Scouttman/STSPIN32G4/STSPIN32G4_V2.kicad_pcb

## KiCad design STSPIN32G4_V2.kicad_pcb (2023-10-10)

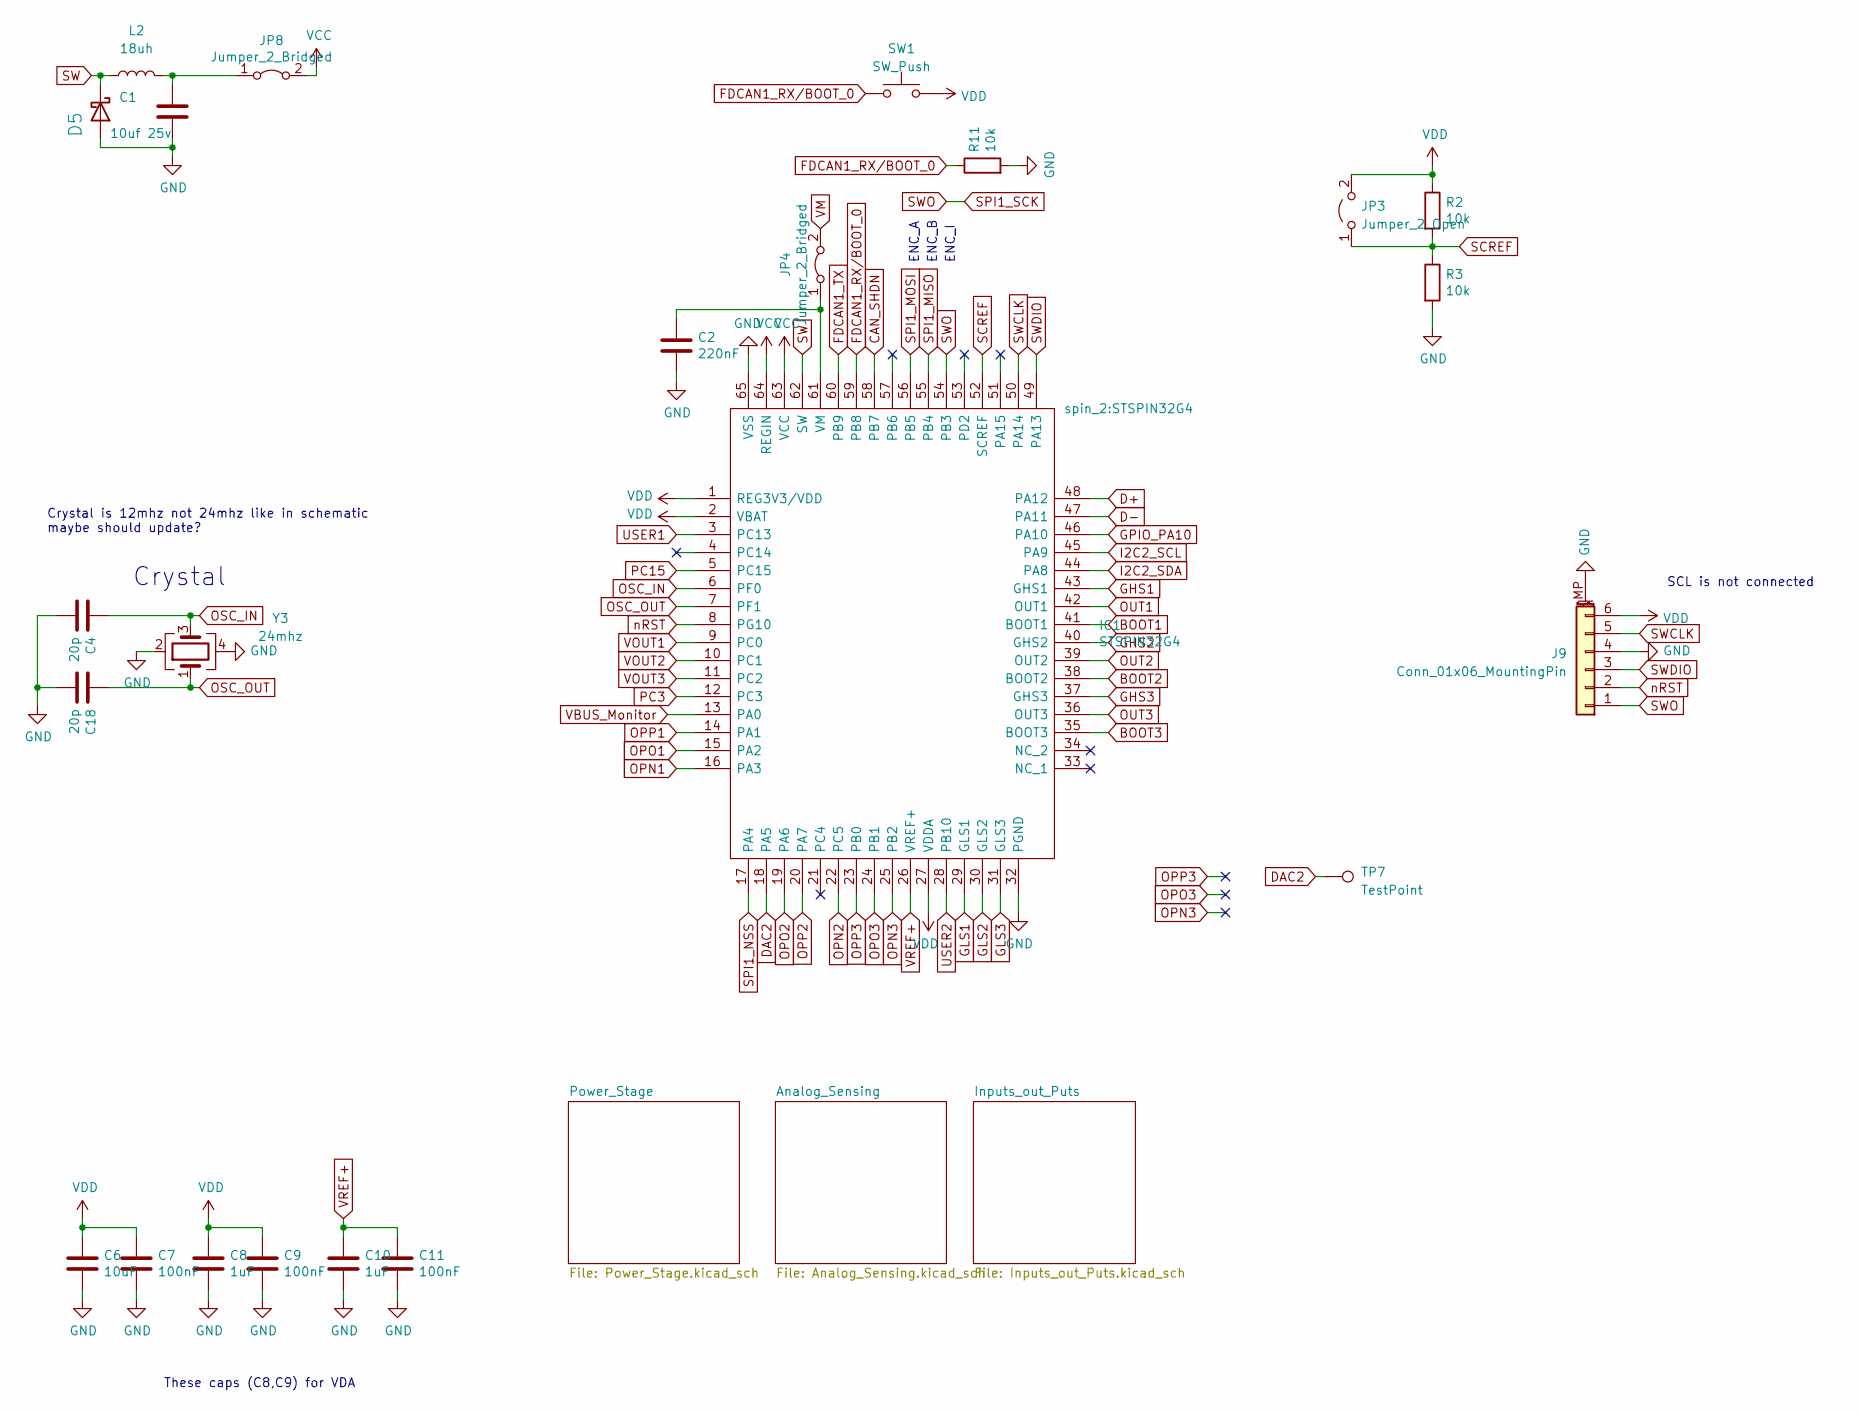
[picture p5: schematic STSPIN32G4_V2.kicad_sch]

Parts:
C1: 10uf 25v; C_0805_2012Metric
C2: 220nF; C_0805_2012Metric
C4, C18: 20p; C_0402_1005Metric
C6: 10uF; C_0805_2012Metric; LCSC Part C15850
C7, C9, C11: 100nF; C_0402_1005Metric
C8, C10: 1uF; C_0402_1005Metric
D5: SS210; D_SOD-323; LCSC C191023
IC1: STSPIN32G4; Manufacturer_Part_Number STSPIN32G4; Mouser Part Number 511-STSPIN32G4
J9: Conn_01x06_MountingPin; JST_SH_BM06B-SRSS-TB_1x06-1MP_P1.00mm_Vertical
JP3: Jumper_2_Open; SolderJumper-2_P1.3mm_Open_TrianglePad1.0x1.5mm
JP4, JP8: Jumper_2_Bridged; SolderJumper-2_P1.3mm_Bridged_RoundedPad1.0x1.5mm
L2: 18uh; L_1812_4532Metric; LCSC C394124
R2, R3, R11: 10k; R_0402_1005Metric
SW1: SW_Push; SolderJumper-2_P1.3mm_Open_RoundedPad1.0x1.5mm
TP7: TestPoint; TestPoint_Pad_D1.5mm
Y3: 24mhz; Crystal_SMD_3225-4Pin_3.2x2.5mm; LCSC C9002

Connections:
BOOT1: IC1.41 (BOOT1); also elsewhere on the board
BOOT2: IC1.38 (BOOT2); also elsewhere on the board
BOOT3: IC1.35 (BOOT3); also elsewhere on the board
CAN_SHDN: IC1.58 (PB7); also elsewhere on the board
D+: IC1.48 (PA12); also elsewhere on the board
D-: IC1.47 (PA11); also elsewhere on the board
DAC2: IC1.18 (PA5), TP7.1; also elsewhere on the board
FDCAN1_RX/BOOT_0: IC1.59 (PB8), R11.1, SW1.1; also elsewhere on the board
FDCAN1_TX: IC1.60 (PB9); also elsewhere on the board
GHS1: IC1.43 (GHS1); also elsewhere on the board
GHS2: IC1.40 (GHS2); also elsewhere on the board
GHS3: IC1.37 (GHS3); also elsewhere on the board
GLS1: IC1.29 (GLS1); also elsewhere on the board
GLS2: IC1.30 (GLS2); also elsewhere on the board
GLS3: IC1.31 (GLS3); also elsewhere on the board
GND: C1.2, C2.2, C4.2, C6.2, C7.2, C8.2, C9.2, C10.2, C11.2, C18.2, D5.2 (A), IC1.32 (PGND), IC1.65 (VSS), J9.4, J9.MP (MountPin), R3.2, R11.2, Y3.2, Y3.4; also elsewhere on the board
GPIO_PA10: IC1.46 (PA10); also elsewhere on the board
I2C2_SCL: IC1.45 (PA9); also elsewhere on the board
I2C2_SDA: IC1.44 (PA8); also elsewhere on the board
unnamed 30: IC1.51 (PA15); also elsewhere on the board
unnamed 31: IC1.53 (PD2); also elsewhere on the board
unnamed: C2.1, IC1.61 (VM), JP4.1 (A)
unnamed: C1.1, JP8.1 (A), L2.2
OPN1: IC1.16 (PA3); also elsewhere on the board
OPN2: IC1.22 (PC5); also elsewhere on the board
OPN3: IC1.25 (PB2)
OPO1: IC1.15 (PA2); also elsewhere on the board
OPO2: IC1.19 (PA6); also elsewhere on the board
OPO3: IC1.24 (PB1)
OPP1: IC1.14 (PA1); also elsewhere on the board
OPP2: IC1.20 (PA7); also elsewhere on the board
OPP3: IC1.23 (PB0)
OSC_IN: C4.1, IC1.6 (PF0), Y3.3
OSC_OUT: C18.1, IC1.7 (PF1), Y3.1
OUT1: IC1.42 (OUT1); also elsewhere on the board
OUT2: IC1.39 (OUT2); also elsewhere on the board
OUT3: IC1.36 (OUT3); also elsewhere on the board
PC3: IC1.12 (PC3)
PC15: IC1.5 (PC15)
SCREF: IC1.52 (SCREF), JP3.1 (A), R2.2, R3.1
SPI1_MISO: IC1.55 (PB4); also elsewhere on the board
SPI1_MOSI: IC1.56 (PB5); also elsewhere on the board
SPI1_NSS: IC1.17 (PA4); also elsewhere on the board
SPI1_SCK: IC1.54 (PB3), J9.1; also elsewhere on the board
SW: D5.1 (K), IC1.62 (SW), L2.1
SWCLK: IC1.50 (PA14), J9.5
SWDIO: IC1.49 (PA13), J9.3
USER1: IC1.3 (PC13); also elsewhere on the board
USER2: IC1.28 (PB10); also elsewhere on the board
VBUS_Monitor: IC1.13 (PA0); also elsewhere on the board
VCC: IC1.63 (VCC), IC1.64 (REGIN), JP8.2 (B); also elsewhere on the board
VDD: C6.1, C7.1, C8.1, C9.1, IC1.1 (REG3V3/VDD), IC1.2 (VBAT), IC1.27 (VDDA), J9.6, JP3.2 (B), R2.1, SW1.2; also elsewhere on the board
VM: JP4.2 (B); also elsewhere on the board
VOUT1: IC1.9 (PC0)
VOUT2: IC1.10 (PC1)
VOUT3: IC1.11 (PC2)
VREF+: C10.1, C11.1, IC1.26 (VREF+); also elsewhere on the board
nRST: IC1.8 (PG10), J9.2

Notes on the sheet:
ENC_I
These caps (C8,C9) for VDA
ENC_B
Crystal
ENC_A
Crystal is 12mhz not 24mhz like in schematic maybe should update?
SCL is not connected

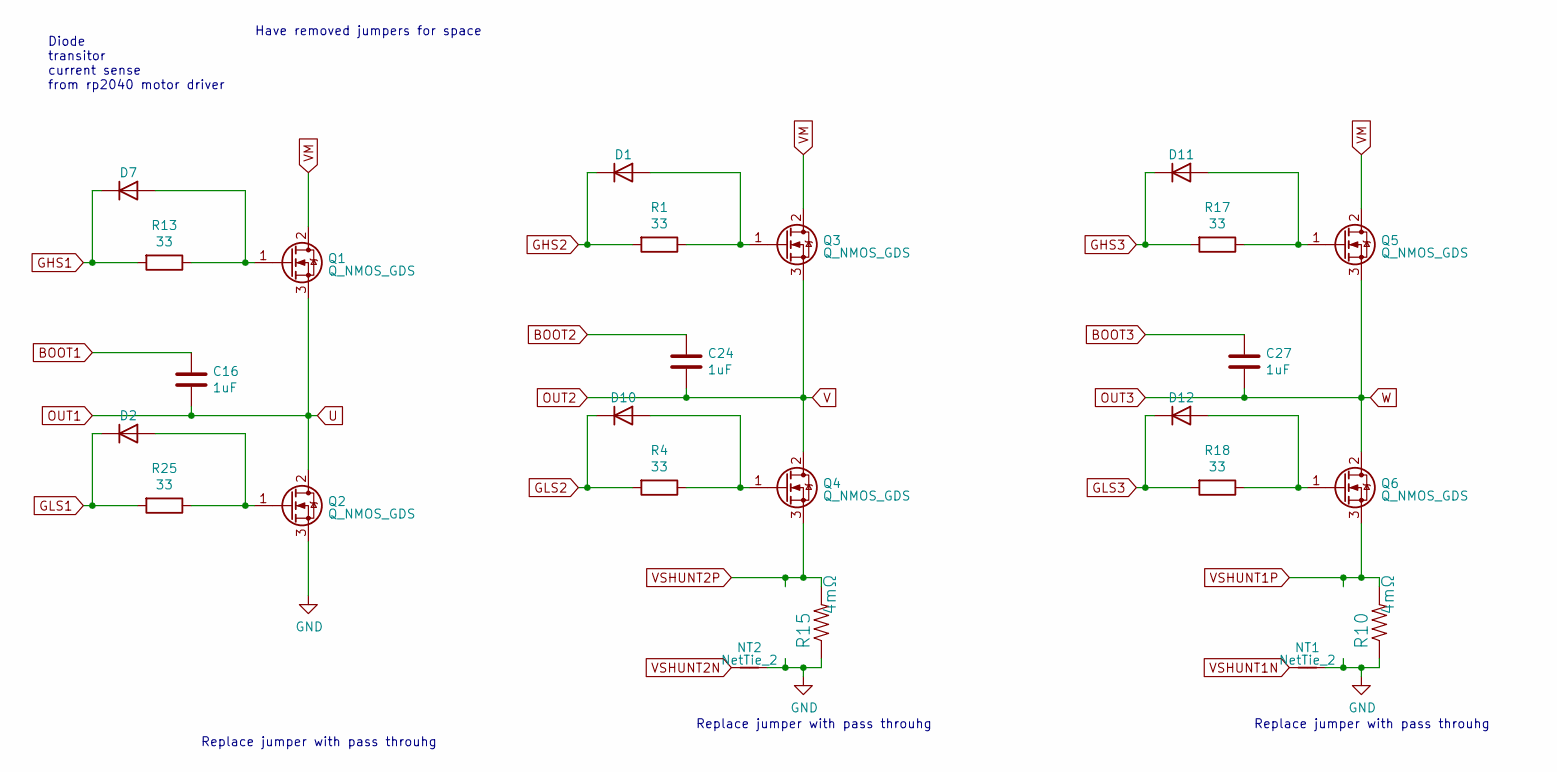
[picture p6: schematic Power_Stage.kicad_sch]

Parts:
C16, C24, C27: 1uF; C_0805_2012Metric; LCSC Part C28323
D1, D2, D7, D10, D11, D12: 1N4148WS; D_SOD-323; LCSC C2128
NT1, NT2: NetTie_2; NetTie-2_SMD_Pad0.5mm
Q1, Q2, Q3, Q4, Q5, Q6: Q_NMOS_GDS; DFN-8-1EP_6x5mm_P1.27mm_EP4x4mm; LCSC Part C180959
R1, R4, R13, R17, R18, R25: 33; R_0402_1005Metric
R10, R15: 4mΩ; R_2512_6332Metric; LCSC C375693

Connections:
BOOT1: C16.2; also elsewhere on the board
BOOT2: C24.2; also elsewhere on the board
BOOT3: C27.2; also elsewhere on the board
GHS1: D7.1 (K), R13.2; also elsewhere on the board
GHS2: D1.1 (K), R1.2; also elsewhere on the board
GHS3: D11.1 (K), R17.2; also elsewhere on the board
GLS1: D2.1 (K), R25.2; also elsewhere on the board
GLS2: D10.1 (K), R4.2; also elsewhere on the board
GLS3: D12.1 (K), R18.2; also elsewhere on the board
GND: NT1.2, NT2.2, Q2.3 (S), R10.1, R15.1; also elsewhere on the board
unnamed: D1.2 (A), Q3.1 (G), R1.1
unnamed: D2.2 (A), Q2.1 (G), R25.1
unnamed: D7.2 (A), Q1.1 (G), R13.1
unnamed: D10.2 (A), Q4.1 (G), R4.1
unnamed: D11.2 (A), Q5.1 (G), R17.1
unnamed: D12.2 (A), Q6.1 (G), R18.1
OUT1: C16.1, Q1.3 (S), Q2.2 (D); also elsewhere on the board
OUT2: C24.1, Q3.3 (S), Q4.2 (D); also elsewhere on the board
OUT3: C27.1, Q5.3 (S), Q6.2 (D); also elsewhere on the board
VM: Q1.2 (D), Q3.2 (D), Q5.2 (D); also elsewhere on the board
VSHUNT1N: NT1.1; also elsewhere on the board
VSHUNT1P: Q6.3 (S), R10.2; also elsewhere on the board
VSHUNT2N: NT2.1; also elsewhere on the board
VSHUNT2P: Q4.3 (S), R15.2; also elsewhere on the board

Notes on the sheet:
Replace jumper with pass throuhg
Have removed jumpers for space
Diode transitor current sense from rp2040 motor driver

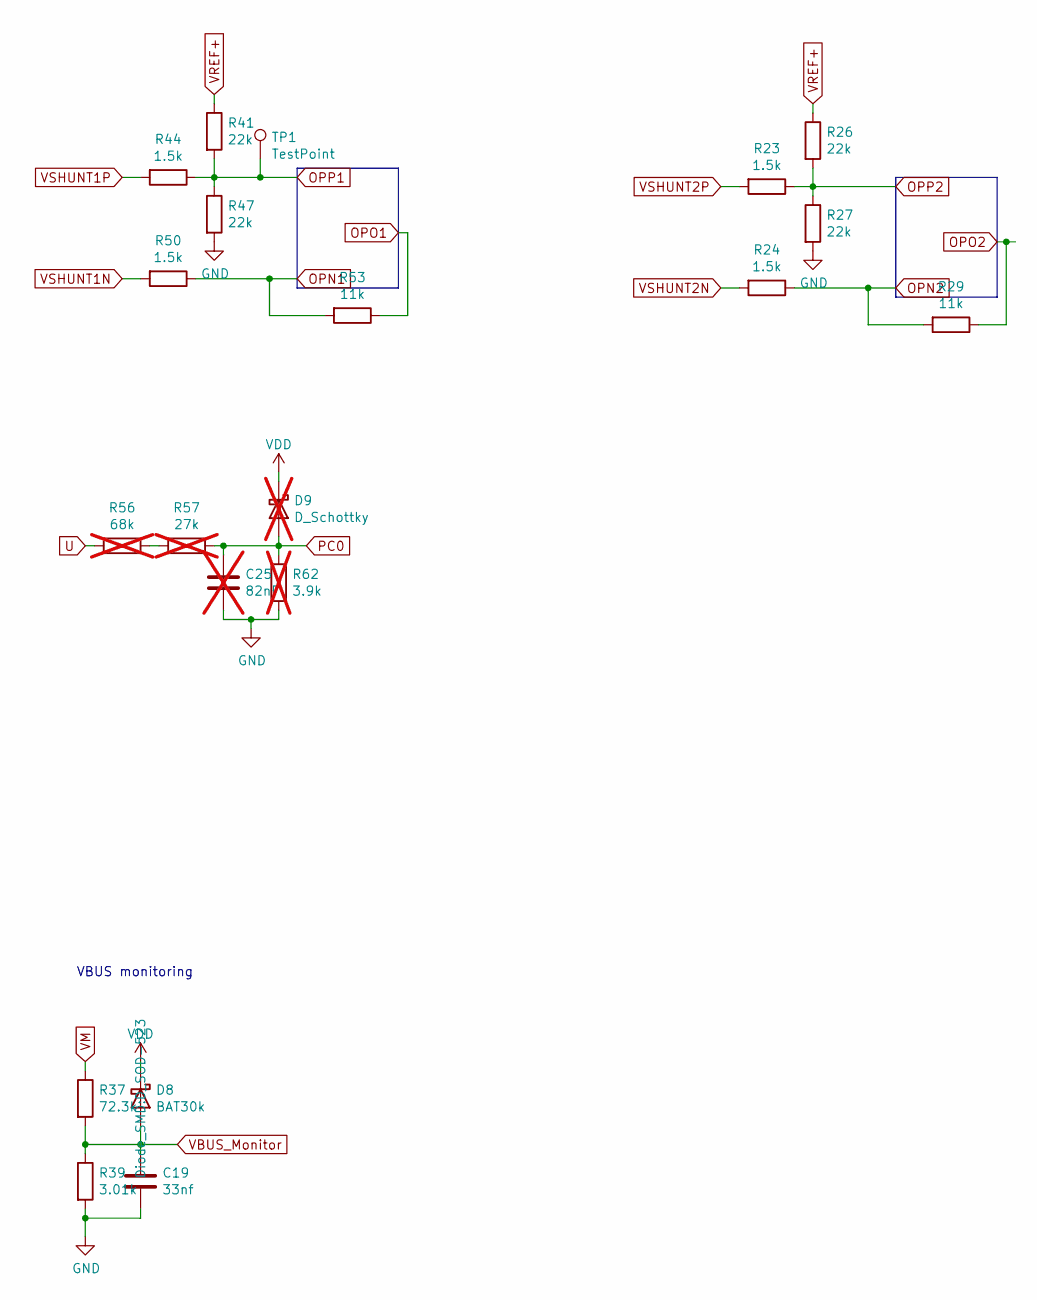
[picture p7: schematic Analog_Sensing.kicad_sch]

Parts:
C19: 33nf; C_0402_1005Metric
C25: 82nF; C_0402_1005Metric; not fitted
D8: BAT30k; D_SOD-523
D9: D_Schottky; D_SOD-523; not fitted
R23, R24, R44, R50: 1.5k; R_0402_1005Metric
R26, R27, R41, R47: 22k; R_0402_1005Metric
R29, R53: 11k; R_0402_1005Metric; LCSC C409665
R37: 72.3k; R_0402_1005Metric
R39: 3.01k; R_0402_1005Metric
R56: 68k; R_0402_1005Metric; not fitted
R57: 27k; R_0402_1005Metric; not fitted
R62: 3.9k; R_0402_1005Metric; not fitted
TP1: TestPoint; TestPoint_Pad_D2.0mm

Connections:
GND: C19.2, C25.2, R27.2, R39.2, R47.2, R62.2; also elsewhere on the board
unnamed: R56.1, R57.2
OPN1: R50.1, R53.2; also elsewhere on the board
OPN2: R24.1, R29.2; also elsewhere on the board
OPO1: R53.1; also elsewhere on the board
OPO2: R29.1; also elsewhere on the board
OPP1: R41.2, R44.1, R47.1, TP1.1; also elsewhere on the board
OPP2: R23.1, R26.2, R27.1; also elsewhere on the board
OUT1: R56.2; also elsewhere on the board
PC0: C25.1, D9.2 (A), R57.1, R62.1
VBUS_Monitor: C19.1, D8.2 (A), R37.2, R39.1; also elsewhere on the board
VDD: D8.1 (K), D9.1 (K); also elsewhere on the board
VM: R37.1; also elsewhere on the board
VREF+: R26.1, R41.1; also elsewhere on the board
VSHUNT1N: R50.2; also elsewhere on the board
VSHUNT1P: R44.2; also elsewhere on the board
VSHUNT2N: R24.2; also elsewhere on the board
VSHUNT2P: R23.2; also elsewhere on the board

Notes on the sheet:
VBUS monitoring

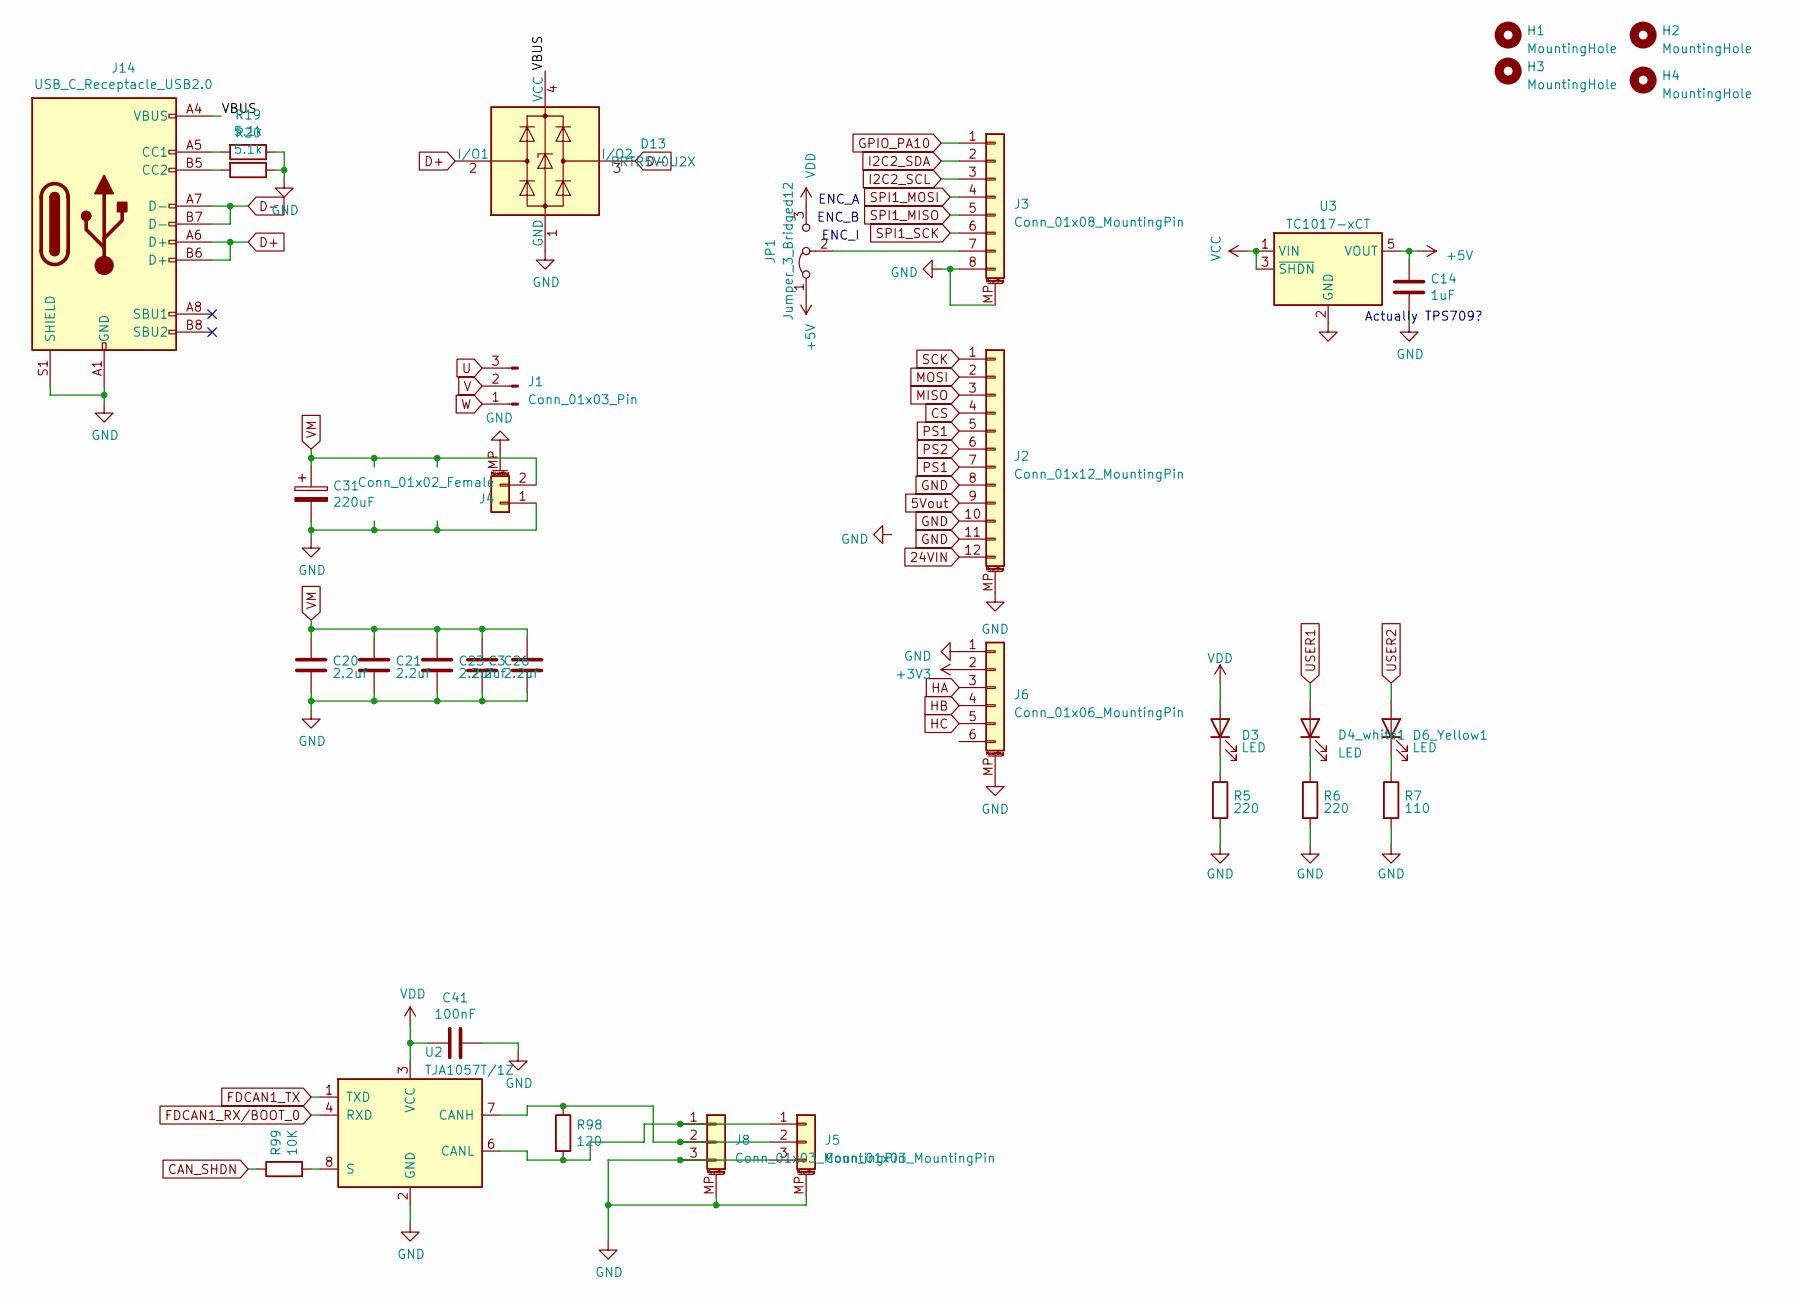
[picture p8: schematic Inputs_out_Puts.kicad_sch]

Parts:
C3, C20, C21, C23, C26: 2.2uf; C_1206_3216Metric; LCSC Part C650969
C14: 1uF; C_0402_1005Metric
C31: 220uF; CP_Elec_8x10; LCSC Part C72524
C41: 100nF; C_0402_1005Metric
D3, D4_white1, D6_Yellow1: LED; LED_0805_2012Metric
D13: PRTR5V0U2X; SOT-143
H1, H2, H3, H4: MountingHole; MountingHole_3.2mm_M3_ISO14580
J1: Conn_01x03_Pin; JST_XH_B3B-XH-AM_1x03_P2.50mm_Vertical
J2: Conn_01x12_MountingPin; TE_1-1734839-2_1x12-1MP_P0.5mm_Horizontal
J3: Conn_01x08_MountingPin; JST_SH_BM08B-SRSS-TB_1x08-1MP_P1.00mm_Vertical
J4: Conn_01x02_Female; AMASS_XT30PW-M_1x02_P2.50mm_Horizontal
J5, J8: Conn_01x03_MountingPin; JST_SH_BM03B-SRSS-TB_1x03-1MP_P1.00mm_Vertical
J6: Conn_01x06_MountingPin; JST_SH_BM06B-SRSS-TB_1x06-1MP_P1.00mm_Vertical
J14: USB_C_Receptacle_USB2.0; USB_C_Receptacle_XKB_U262-16XN-4BVC11; LCSC Part C165948
JP1: Jumper_3_Bridged12; SolderJumper-3_P1.3mm_Bridged2Bar12_RoundedPad1.0x1.5mm_Num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
R5, R6: 220; R_0402_1005Metric
R7: 110; R_0402_1005Metric
R19: 5.1k; R_0402_1005Metric
R20: 5.1k; R_0402_1005Metric; LCSC Part C23186
R98: 120; R_0402_1005Metric
R99: 10K; R_0402_1005Metric
U2: TJA1057T/1Z; SOIC-8_3.9x4.9mm_P1.27mm; LCSC C961484
U3: TC1017-xCT; SOT-23-5; LCSC C626434

Connections:
+5V: C14.1, JP1.1 (A), U3.5 (VOUT)
/Inputs_out_Puts/VBUS: D13.4 (VCC), J14.A4 (VBUS), J14.A9 (VBUS), J14.B4 (VBUS), J14.B9 (VBUS)
CAN_SHDN: R99.1; also elsewhere on the board
D+: D13.2 (I/O1), J14.A6 (D+), J14.B6 (D+); also elsewhere on the board
D-: D13.3 (I/O2), J14.A7 (D-), J14.B7 (D-); also elsewhere on the board
FDCAN1_RX/BOOT_0: U2.4 (RXD); also elsewhere on the board
FDCAN1_TX: U2.1 (TXD); also elsewhere on the board
GND: C3.2, C14.2, C20.2, C21.2, C23.2, C26.2, C31.2, C41.1, D13.1 (GND), J2.MP (MountPin), J3.8, J3.MP (MountPin), J4.1, J4.MP (MountPin), J5.3, J5.MP (MountPin), J6.1, J6.MP (MountPin), J8.3, J8.MP (MountPin), J14.A1 (GND), J14.A12 (GND), J14.B1 (GND), J14.B12 (GND), J14.S1 (SHIELD), R5.2, R6.2, R7.2, R19.1, R20.1, U2.2 (GND), U3.2 (GND); also elsewhere on the board
GPIO_PA10: J3.1; also elsewhere on the board
I2C2_SCL: J3.3; also elsewhere on the board
I2C2_SDA: J3.2; also elsewhere on the board
unnamed: D3.1 (K), R5.1
unnamed: D4_white1.1 (K), R6.1
unnamed: D6_Yellow1.1 (K), R7.1
unnamed: J2.5, J2.7
unnamed: J2.8, J2.10, J2.11
unnamed: J3.7, JP1.2 (C)
unnamed: J5.1, J8.1, R98.2, U2.6 (CANL)
unnamed: J5.2, J8.2, R98.1, U2.7 (CANH)
unnamed: J14.A5 (CC1), R19.2
unnamed: J14.B5 (CC2), R20.2
unnamed: R99.2, U2.8 (S)
OUT1: J1.3; also elsewhere on the board
OUT2: J1.2; also elsewhere on the board
OUT3: J1.1; also elsewhere on the board
SPI1_MISO: J3.5; also elsewhere on the board
SPI1_MOSI: J3.4; also elsewhere on the board
SPI1_SCK: J3.6; also elsewhere on the board
USER1: D4_white1.2 (A); also elsewhere on the board
USER2: D6_Yellow1.2 (A); also elsewhere on the board
VCC: U3.1 (VIN), U3.3 (~SHDN); also elsewhere on the board
VDD: C41.2, D3.2 (A), JP1.3 (B), U2.3 (VCC); also elsewhere on the board
VM: C3.1, C20.1, C21.1, C23.1, C26.1, C31.1, J4.2; also elsewhere on the board

Notes on the sheet:
ENC_A
Actually TPS709?
ENC_B
ENC_I

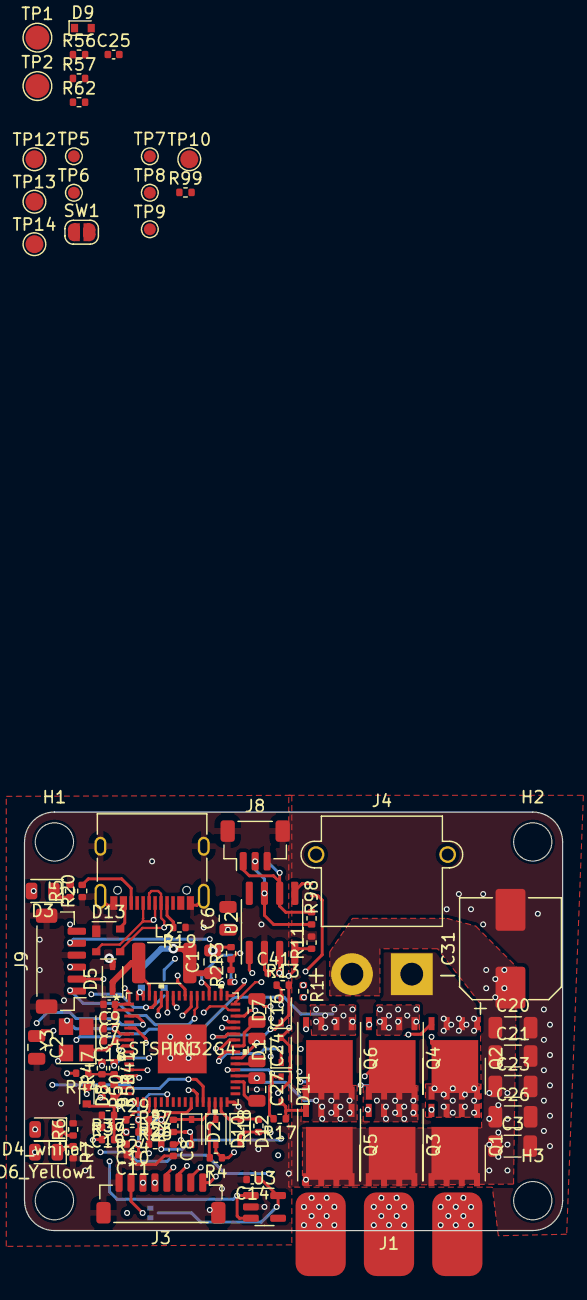
[picture p9: board STSPIN32G4_V2.kicad_pcb from above]

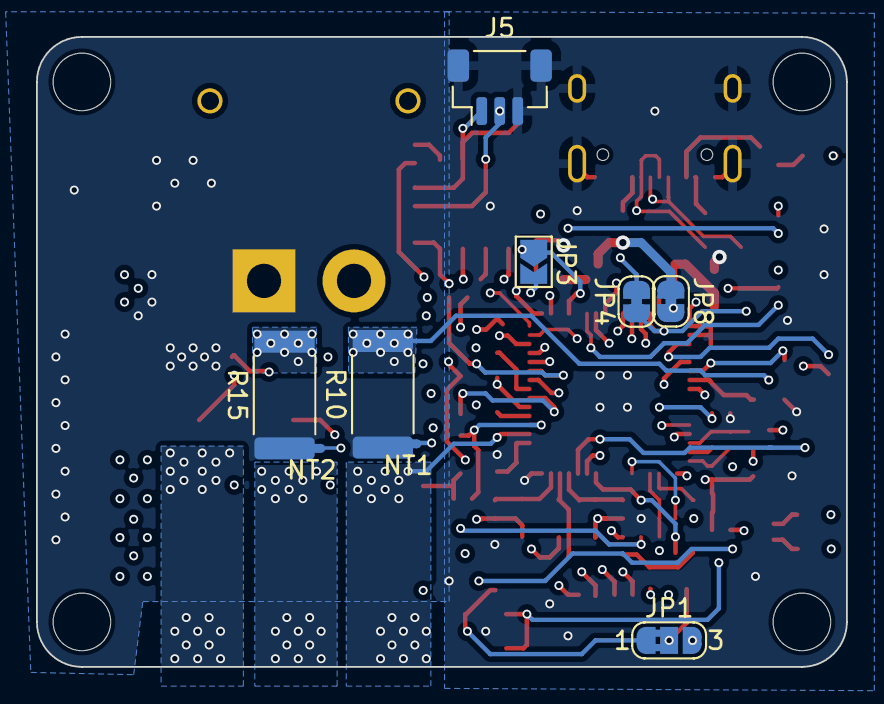
[picture p10: board STSPIN32G4_V2.kicad_pcb from below]

Board: 4 copper layers, 45.0 x 35.0 mm, 109 parts (9 on the bottom side), 73 nets.

Other parts of the board:
TP2: TestPoint; TestPoint_Pad_D2.0mm
TP5, TP6, TP8, TP9: TestPoint; TestPoint_Pad_D1.0mm
TP10, TP12, TP13, TP14: TestPoint; TestPoint_Pad_D1.5mm

Their connections:
DAC2: TP14.1; also elsewhere on the board
unnamed 30: TP12.1; also elsewhere on the board
unnamed 31: TP13.1; also elsewhere on the board
OPO1: TP2.1; also elsewhere on the board
SPI1_NSS: TP10.1; also elsewhere on the board
VCC: TP6.1; also elsewhere on the board
VDD: TP5.1; also elsewhere on the board
