Scouttman/STSPIN32G4/(commit log)

2023-10-10 revision 4
    [Analog_Sensing.kicad_sch, BOM-STSPIN32G4.csv, Inputs_out_Puts.kicad_sch, Power_Stage.kicad_sch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]
2023-10-10 jlcpcb production files
    [BOM-STSPIN32G4_V2.csv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]
2023-10-23 uploaded missing schematics
    [STSPIN32G4_V2.kicad_sch]
